hanpig1998/2018-summer-artificial-car/README.md

# 2018 summer artificial car

电子技术课程设计小学期  
code：hanpig1998
