hanpig1998/2018-summer-artificial-car/(list of files, drawings)

Other design files:
simulation/Design1.ms14
simulation/呼吸灯2.ms14
simulation/呼吸灯.ms14
simulation/正弦振荡1.ms14
simulation/设计1.ms14
